lgpf/xpc-minimodem/stl/xpc-minimodem-cable-tpu.stl

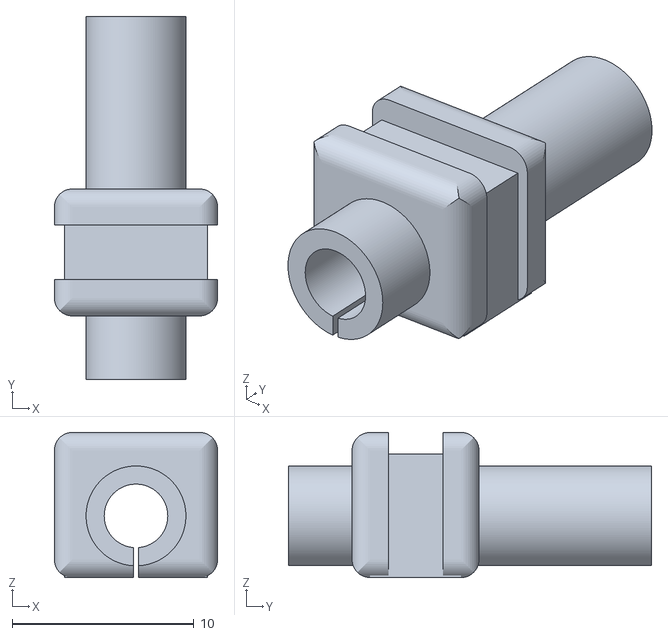
[picture p3: CAD file, 2026-11-09]
stl/xpc-minimodem-cable-tpu.stl
9.00 x 20.0 x 8.00
