lgpf/xpc-minimodem/stl/xpc-minimodem-top.stl

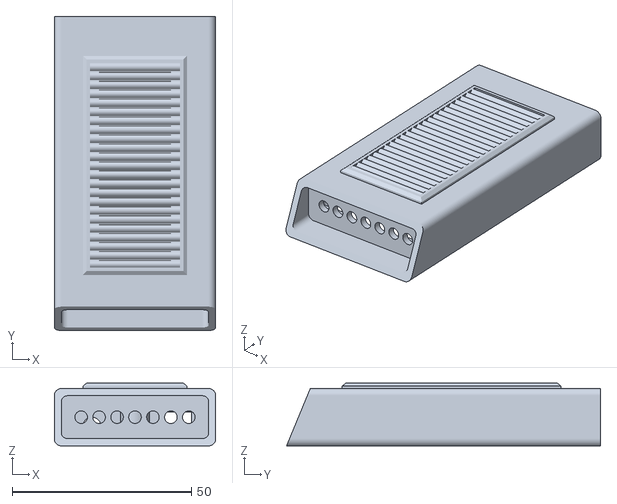
[picture p4: CAD file, 2026-11-09]
stl/xpc-minimodem-top.stl
45.0 x 87.5 x 17.5
