lgpf/xpc-minimodem/stl/xpc-minimodem-bottom.stl

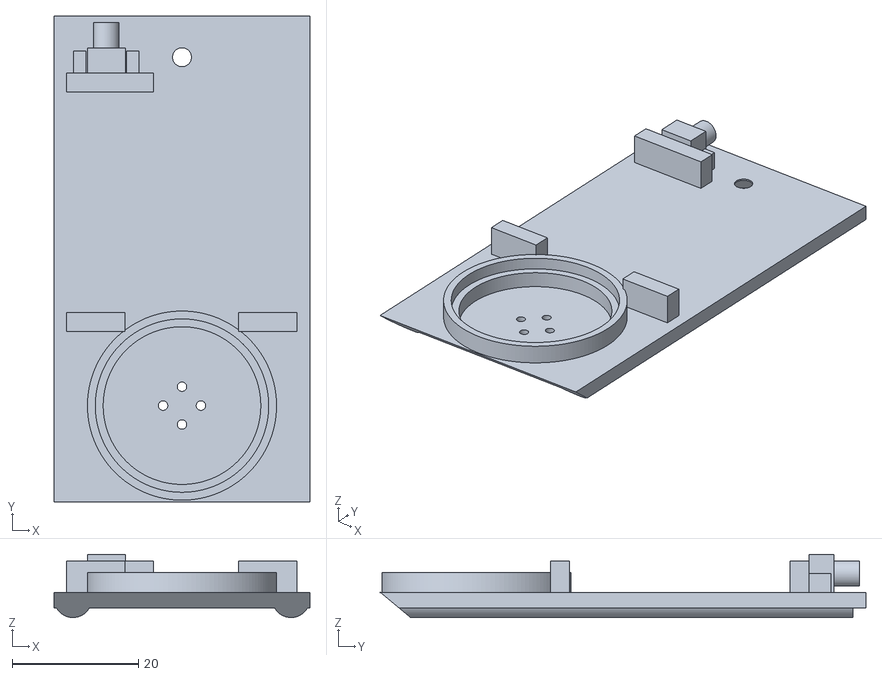
[picture p5: CAD file, 2026-11-09]
stl/xpc-minimodem-bottom.stl
40.6 x 77.0 x 10.0
