lgpf/xpc-minimodem/firmware/RetroWiFiModemXPC/RetroWiFiModem.h

#ifndef _MODEM_H
   #define _MODEM_H

   #define DEBUG                 0

   // XPC: versao para ligar direto na porta do mouse da TTGO VGA32 (Cobra XPC / FabGL PCEmulator):
   //   so TX/RX em TTL 3,3V, sem MAX3232, sem DFPlayer/som, sem sinais de controle (DTR/DCD/RTS/CTS/RI)
   #define XPC_DIRECT            1

   #if XPC_DIRECT
      #define DEFAULT_SPEED      9600
   #else
      #define DEFAULT_SPEED      1200
   #endif

   #define RING_INTERVAL         1500
   #define MAX_CMD_LEN           256
   #define TX_BUF_SIZE           256
   #define ESC_CHAR              '+'
   #define ESC_COUNT             3
   #define GUARD_TIME            1000
   #define MAGIC_NUMBER          0x5106
   #define MAX_SSID_LEN          32
   #define MAX_WIFI_PWD_LEN      64
   #define DEFAULT_LISTEN_PORT   6400
   #define TELNET_PORT           23
   #define HTTP_PORT             80
   #define SPEED_DIAL_SLOTS      10
   #define MAGIC_ANSWER_RINGS    3
   #define MAX_ALIAS_LEN         16
   #define MAX_SPEED_DIAL_LEN    50
   #define MAGIC_SPEED_LEN       7
   #define MAX_PPP_LEN           16
   #define MAX_MDNSNAME_LEN      80
   #define MAX_HOSTNAME_LEN      24
   #define MAX_BUSYMSG_LEN       80
   #define MAX_PWD_LEN           80
   #define PASSWORD_TIME         60000
   #define PASSWORD_TRIES        3
   #define MAX_AUTOEXEC_LEN      80
   #define MAX_TERMINAL_LEN      80
   #define MAX_LOCATION_LEN      80

   #define NUL  '\x00'
   #define CTLC '\x03'
   #define BS   '\x08'
   #define LF   '\x0A'
   #define CR   '\x0D'
   #define DEL  '\x7F'

   #define NO_TELNET   ((uint8_t)0)
   #define REAL_TELNET ((uint8_t)1)
   #define FAKE_TELNET ((uint8_t)2)

   // Telnet codes
   #define VLSUP     ((uint8_t)0)
   #define VLREQ     ((uint8_t)1)
   #define LOC       ((uint8_t)23)
   #define TTYPE     ((uint8_t)24)
   #define NAWS      ((uint8_t)31)
   #define TSPEED    ((uint8_t)32)
   #define LFLOW     ((uint8_t)33)
   #define LINEMODE  ((uint8_t)34)
   #define XDISPLOC  ((uint8_t)35)
   #define NEW_ENVIRON ((uint8_t)39)
   #define MSDP      ((uint8_t)69)  //
   #define MSSP      ((uint8_t)70)  //
   #define MCCP      ((uint8_t)85)  //
   #define MCCP2     ((uint8_t)86)  //
   #define MCCP3     ((uint8_t)87)  // MUD Telnet extensions
   #define MSP       ((uint8_t)91)  //
   #define MXP       ((uint8_t)93)  //
   #define GMCP      ((uint8_t)201) //
   #define BINARY    ((uint8_t)0)
   #define ECHO      ((uint8_t)1)
   #define SUP_GA    ((uint8_t)3)
   #define SE        ((uint8_t)240)
   #define DM        ((uint8_t)242)
   #define AYT       ((uint8_t)246)
   #define SB        ((uint8_t)250)
   #define WILL      ((uint8_t)251)
   #define WONT      ((uint8_t)252)
   #define DO        ((uint8_t)253)
   #define DONT      ((uint8_t)254)
   #define IAC       ((uint8_t)255)

   #define NIST_HOST "time.nist.gov"
   #define NIST_PORT 13

   #define ACTIVE LOW           // RS232 control signals are active low

   // As the ESP8266 is being used as a modem (DCE) in this application,
    // I've reversed the naming of RTS/CTS to match what they'd be on
    // a modem. The usual naming is correct if the ESP8266 is wired up as
    // a DTE, but kept confusing me here as it's wired up as a DCE.
   #ifdef ARDUINO_ESP8266_WEMOS_D1R1
      // D1 R1 pins
      #define CTS D10           // (GPIO15) output
      #define RTS D11           // (GPIO13) input
      #define RI  D12           // (GPIO12) output
      #define DSR D4            // (GPIO04) output
      #define DCD D3            // (GPIO05) output
      #define DTR D8            // (GPIO00) input
      #define TXEN D5           // (GPIO14) output
      #define BUSY D2           // (GPIO16) input
   #endif

   #ifdef ARDUINO_ESP8266_WEMOS_D1MINI
      // D1 mini pins
      #define CTS D8            // (GPIO15) output
      #define RTS D7            // (GPIO13) input
      #define RI  D6            // (GPIO12) output
      #define DSR D2            // (GPIO04) output
      #define DCD D1            // (GPIO05) output
      #define DTR D3            // (GPIO00) input
      #define TXEN D5           // (GPIO14) output
      #define BUSY D0           // (GPIO16) input
   #endif

   // Sound player definitions
   #define SOUND_DIAL_TONE 1
   #define SOUND_DIALLING (SOUND_DIAL_TONE+1)
   #define NUM_DIAL_SOUNDS 10
   #define SOUND_RING (SOUND_DIALLING+NUM_DIAL_SOUNDS)
   #define SOUND_CONNECT_300 (SOUND_RING+1)
   #define SOUND_CONNECT_1200 (SOUND_CONNECT_300+1)
   #define SOUND_CONNECT_9600 (SOUND_CONNECT_1200+1)

#endif
