lgpf/xpc-minimodem/firmware/RetroWiFiModemXPC/RetroWiFiModemXPC.ino

//
//   Retro WiFi modem: an ESP8266 based RS232<->WiFi modem
//   with Hayes style AT commands and blinking LEDs.
//
//   Originally based on
//   Original Source Copyright (C) 2016 Jussi Salin <salinjus@gmail.com>
//   Additions (C) 2018 Daniel Jameson, Stardot Contributors
//   Additions (C) 2018 Paul Rickards <rickards@gmail.com>
//
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

#include <lwip/napt.h>
#include <lwip/dns.h>
#include <lwip/netif.h>
#include <netif/ppp/ppp.h>
#include <netif/ppp/pppos.h>

#include <ESP8266WiFi.h>
#include <ESP_EEPROM.h>
#include <WiFiUdp.h>
#include <ArduinoOTA.h>
#include <uart_register.h>
#include <string.h>
#include "RetroWiFiModem.h"
#include "globals.h"
#include "support.h"
#include "player.h"
#if XPC_DIRECT
#include "xpcsound.h"
#endif
#include "ppp.h"
#include "at_basic.h"
#include "at_extended.h"
#include "at_proprietary.h"

// =============================================================
void setup(void) {
   bool ok = true;

   pinMode(RI, OUTPUT);
   pinMode(DCD, OUTPUT);
   pinMode(DSR, OUTPUT);
   digitalWrite(TXEN, HIGH);     // continue disabling TX until
   pinMode(TXEN, OUTPUT);        // we have set up the Serial port
   pinMode(DTR, INPUT);

   digitalWrite(RI, !ACTIVE);    // not ringing
   digitalWrite(DCD, !ACTIVE);   // not connected
   digitalWrite(DSR, !ACTIVE);   // modem is not ready

   // the esp fork of LWIP doesn't automatically init when enabling nat, so just do it in setup
   ip_napt_init(IP_NAPT_MAX, IP_PORTMAP_MAX);

   EEPROM.begin(sizeof(struct Settings));
   EEPROM.get(0, settings);
   if( settings.magicNumber != MAGIC_NUMBER ) {
      // no valid data in EEPROM/NVRAM, populate with defaults
      factoryDefaults(NULL);
   }
   sessionTelnetTypeSend = settings.telnet;
   sessionTelnetTypeReceive = settings.telnet;

   playerInit();
#if XPC_DIRECT
   sndInit();                    // piezo em D5 (GPIO14) e G
#endif
   playerSetVolume(settings.volume);
   if( !settings.speaker ) {
      playerMute();
   }

   Serial.begin(settings.serialSpeed, getSerialConfig());
   digitalWrite(TXEN, LOW);      // enable the TX output
   updateHardwareFlow();         // update CTS/RTS
#if XPC_DIRECT
   settings.rtsCts = false;                       // sem RTS/CTS no cabo
   settings.dtrHandling = DTR_IGNORE;             // sem DTR no cabo
#endif
   if( settings.rtsCts ) {
      setHardwareFlow();
   }
   // enable interrupt when DTR goes inactive if we're not ignoring it
   if( settings.dtrHandling != DTR_IGNORE ) {
      attachInterrupt(digitalPinToInterrupt(DTR), dtrIrq, RISING);
   }
   if( settings.startupWait ) {
      while( true ) {            // wait for a CR
         yield();
         if( Serial.available() ) {
            if( Serial.read() == CR ) {
               break;
            }
         }
      }
   }

   if( settings.hostName[0] ) {
     WiFi.hostname(settings.hostName);
   }

   WiFi.setAutoConnect(false);
   if( settings.ssid[0] && settings.wifiPassword[0] ) {
      WiFi.begin(settings.ssid, settings.wifiPassword);
      WiFi.waitForConnectResult();
      WiFi.mode(WIFI_STA);
   } else {
      WiFi.begin();
   }
   WiFiClient::setDefaultNoDelay(true);  // disable Nalge algorithm by default

   if( settings.listenPort ) {
      tcpServer.begin(settings.listenPort);
   }

   if( settings.ssid[0] && WiFi.status() == WL_CONNECTED ) {
      setupOTAupdates();
   }

   if( WiFi.status() == WL_CONNECTED || !settings.ssid[0] ) {
      if( WiFi.status() == WL_CONNECTED ) {
         digitalWrite(DSR, ACTIVE);  // modem is finally ready or SSID not configured
      }
      if( settings.autoExecute[0] ) {
         strncpy(atCmd, settings.autoExecute, MAX_CMD_LEN);
         atCmd[MAX_CMD_LEN] = NUL;
         if( settings.echo ) {
            Serial.println(atCmd);
         }
         doAtCmds(atCmd);                  // auto execute command
      } else {
         sendResult(R_OK);
      }
   } else {
      sendResult(R_ERROR);           // SSID configured, but not connected
   }

   playerSetVolume(settings.volume);
   if( !settings.speaker ) {
      playerMute();
   }
}

// =============================================================
void loop(void) {

   checkForIncomingCall();

   if( settings.dtrHandling == DTR_RESET && checkDtrIrq() ) {
      resetToNvram(NULL);
   }

   digitalWrite(DSR, WiFi.status() == WL_CONNECTED ? ACTIVE : !ACTIVE);

   switch( state ) {

      case CMD_NOT_IN_CALL:
         if( WiFi.status() == WL_CONNECTED ) {
            ArduinoOTA.handle();
         }
         inAtCommandMode();
         break;

      case CMD_IN_CALL:
         inAtCommandMode();
         if( state == CMD_IN_CALL && !ppp && !tcpClient.connected() ) {
            endCall();                    // hang up if not in a call
         }
         break;

      case PASSWORD:
         inPasswordMode();
         break;

      case ONLINE:
         if( Serial.available() ) {       // data from RS-232 to Wifi
            sendSerialData();
         }

         while( !ppp && tcpClient.available() && !Serial.available() ) { // data from WiFi to RS-232
            int c = receiveTcpData();
            if( c != -1 ) {
               Serial.write((char)c);
            }
         }

         if( escCount == ESC_COUNT && startGuardTime && millis() - startGuardTime > GUARD_TIME ) {
            state = CMD_IN_CALL;          // +++ detected, back to command mode
            sendResult(R_OK);
            escCount = 0;
         }

         if( settings.dtrHandling != DTR_IGNORE && checkDtrIrq() ) {
            switch( settings.dtrHandling ) {

               case DTR_GOTO_COMMAND:
                  state = CMD_IN_CALL;
                  sendResult(R_OK);
                  escCount = 0;
                  break;

               case DTR_END_CALL:
                  endCall();
                  break;

               case DTR_RESET:
                  resetToNvram(NULL);
                  break;

               default:
                  break;
            }
         }

         if( !ppp && !tcpClient.connected() ) {   // no client?
            endCall();                    // then hang up
         }
         break;
   }
}

// =============================================================
void doAtCmds(char *atCmd) {
   size_t len;

   trim(atCmd);               // get rid of leading and trailing spaces
   if( atCmd[0] ) {
      // is it an AT command?
      if( strncasecmp(atCmd, "AT", 2) ) {
         sendResult(R_ERROR); // nope, time to die
      } else {
         // save command for possible future A/
         strncpy(lastCmd, atCmd, MAX_CMD_LEN);
         lastCmd[MAX_CMD_LEN] = NUL;
         atCmd += 2;          // skip over AT prefix
         len = strlen(atCmd);

         if( !atCmd[0] ) {
            // plain old AT
            sendResult(R_OK);
         } else {
            trim(atCmd);
            while( atCmd[0] ) {
               char * before = atCmd;   // XPC: comando que nao avanca (erro) encerra a linha
               // XPC: "AT?" sozinho e sempre a ajuda (mesmo depois de um ATSn da string de init do terminal)
               if( !strncasecmp(atCmd, "?", 1) && (selectedRegister < 0 || !atCmd[1]) ) { // help message
                  // help
                  atCmd = showHelp(atCmd + 1);
               } else if( !strncasecmp(atCmd, "$AYT", 4) ) {
                  atCmd = doAreYouThere(atCmd + 4);
               } else if( !strncasecmp(atCmd, "$SB", 3) ) {
                  // query/set serial speed
                  atCmd = doSpeedChange(atCmd + 3);
               } else if( !strncasecmp(atCmd, "$SU", 3) ) {
                  // query/set serial data configuration
                  atCmd = doDataConfig(atCmd + 3);
               } else if( !strncasecmp(atCmd, "$SSID", 5) ) {
                  // query/set WiFi SSID
                  atCmd = doSSID(atCmd + 5);
               } else if( !strncasecmp(atCmd, "$PASS", 5) ) {
                  // query/set WiFi password
                  atCmd = doWiFiPassword(atCmd + 5);
               } else if( !strncasecmp(atCmd, "C", 1) ) {
                  // connect/disconnect to WiFi
                  atCmd = wifiConnection(atCmd + 1);
               } else if( !strncasecmp(atCmd, "D", 1) && len > 2 && strchr("TPI", toupper(atCmd[1])) ) {
                  // dial a number
                  atCmd = dialNumber(atCmd + 2);
               } else if( !strncasecmp(atCmd, "DS", 2) && len == 3 ) {
                  // speed dial a number
                  atCmd = speedDialNumber(atCmd + 2);
               } else if( !strncasecmp(atCmd, "H0", 2) ) {
                  // hang up call
                  atCmd = hangup(atCmd + 2);
               } else if( !strncasecmp(atCmd, "H", 1) && !isDigit(atCmd[1]) ) {
                  // hang up call
                  atCmd = hangup(atCmd + 1);
               } else if( !strncasecmp(atCmd, "&Z", 2) && isDigit(atCmd[2]) ) {
                  // speed dial query or set
                  atCmd = doSpeedDialSlot(atCmd + 2);
               } else if( !strncasecmp(atCmd, "L", 1) ) {
                  // query/set speaker volume
                  atCmd = doSpeakerVolume(atCmd + 1);
               } else if( !strncasecmp(atCmd, "M", 1) ) {
                  // turn speaker on/off
                  atCmd = doSpeaker(atCmd + 1);
               } else if( !strncasecmp(atCmd, "O", 1) ) {
                  // go online
                  atCmd = goOnline(atCmd + 1);
               } else if( !strncasecmp(atCmd, "GET", 3) ) {
                  // get a web page (http only, no https)
                  atCmd = httpGet(atCmd + 3);
               } else if( settings.listenPort && !strncasecmp(atCmd, "A", 1) && tcpServer.hasClient() ) {
                  // manually answer incoming connection
                  atCmd = answerCall(atCmd + 1);
               } else if( !strncasecmp(atCmd, "S", 1) && isDigit(atCmd[1]) ) {
                  // select register
                  atCmd = doSelectRegister(atCmd + 1);
               } else if ( !strncasecmp(atCmd, "=", 1) && isDigit(atCmd[1]) ) {
                  // set register
                  atCmd = doSetRegister(atCmd + 1);
               } else if ( !strncasecmp(atCmd, "?", 1) ) {
                  // query register
                  atCmd = doQueryRegister(atCmd + 1);
               } else if( !strncasecmp(atCmd, "S0", 2) ) {
                  // query/set auto answer
                  atCmd = doAutoAnswerConfig(atCmd + 2);
               } else if( !strncasecmp(atCmd, "S2", 2) ) {
                  // query/set escape character
                  atCmd = doEscapeCharConfig(atCmd + 2);
               } else if( !strncasecmp(atCmd, "$SP", 3) ) {
                  // query set inbound TCP port
                  atCmd = doServerPort(atCmd + 3);
               } else if( !strncasecmp(atCmd, "$BM", 3) ) {
                  // query/set busy message
                  atCmd = doBusyMessage(atCmd + 3);
               } else if( !strncasecmp(atCmd, "&R", 2) && strncasecmp(atCmd + 2, "S", 1) ) {
                  // query/set require password
                  atCmd = doServerPassword(atCmd + 2);
               } else if( !strncasecmp(atCmd, "I", 1) ) {
                  // show network information
                  atCmd = showNetworkInfo(atCmd + 1);
               } else if( !strncasecmp(atCmd, "Z", 1) ) {
                  // reset to NVRAM
                  atCmd = resetToNvram(atCmd + 1);
               } else if( !strncasecmp(atCmd, "&D", 2) ) {
                  //query/set DTR handling
                  atCmd = doDtrHandling(atCmd + 2);
               } else if( !strncasecmp(atCmd, "&V", 2) ) {
                  // display current and stored settings
                  atCmd = displayAllSettings(atCmd + 2);
               } else if( !strncasecmp(atCmd, "&W", 2) ) {
                  // write settings to EEPROM
                  atCmd = updateNvram(atCmd + 2);
               } else if( !strncasecmp(atCmd, "&F", 2) ) {
                  // factory defaults
                  atCmd = factoryDefaults(atCmd);
               } else if( !strncasecmp(atCmd, "E", 1) ) {
                  // query/set command mode echo
                  atCmd = doEcho(atCmd + 1);
               } else if( !strncasecmp(atCmd, "Q", 1) ) {
                  // query/set quiet mode
                  atCmd = doQuiet(atCmd + 1);
               } else if( !strncasecmp(atCmd, "RD", 2)
                       || !strncasecmp(atCmd, "RT", 2) ) {
                  // read time and date
                  atCmd = doDateTime(atCmd + 2);
               } else if( !strncasecmp(atCmd, "V", 1) ) {
                  // query/set verbose mode
                  atCmd = doVerbose(atCmd + 1);
               } else if( !strncasecmp(atCmd, "X", 1) ) {
                  // query/set extended result codes
                  atCmd = doExtended(atCmd + 1);
               } else if( !strncasecmp(atCmd, "$W", 2) ) {
                  // query/set startup wait
                  atCmd = doStartupWait(atCmd + 2);
               } else if( !strncasecmp(atCmd, "NET", 3) ) {
                  // query/set telnet mode
                  atCmd = doTelnetMode(atCmd + 3);
               } else if( !strncasecmp(atCmd, "$AE", 3) ) {
                  // do auto execute commands
                  atCmd = doAutoExecute(atCmd + 3);
               } else if( !strncasecmp(atCmd, "$TTY", 4) ) {
                  // do telnet terminal type
                  atCmd = doTerminalType(atCmd + 4);
               } else if( !strncasecmp(atCmd, "$TTL", 4) ) {
                  // do telnet location
                  atCmd = doLocation(atCmd + 4);
               } else if( !strncasecmp(atCmd, "$TTS", 4) ) {
                  // do telnet location
                  atCmd = doWindowSize(atCmd + 4);
               } else if( !strncasecmp(atCmd, "&K", 2) ) {
                  // do RTS/CTS flow control
                  atCmd = doFlowControl(atCmd + 2);
               } else if( !strncasecmp(atCmd, "&CS", 3) ) {
                  // do manual CTS control
                  atCmd = doCtsControl(atCmd + 3);
               } else if( !strncasecmp(atCmd, "&RS", 3) ) {
                  // do manual RTS control
                  atCmd = doRtsControl(atCmd + 3);
               } else if( !strncasecmp(atCmd, "$MDNS", 5) ) {
                  // handle mDNS name
                  atCmd = doMdnsName(atCmd + 5);
               } else if( !strncasecmp(atCmd, "$HOST", 5) ) {
                  // handle hostname
                  atCmd = doHostName(atCmd + 5);
               } else if( !strncasecmp(atCmd, "M", 1) ) {
                  // speaker mute
                  atCmd = doSpeakerMute(atCmd + 1);
               } else if( !strncasecmp(atCmd, "L", 1) ) {
                  // speaker loudness
                  atCmd = doSpeakerLoudness(atCmd + 1);
               } else if( !strncasecmp(atCmd, "+FCLASS=", 8) ) {
                  // voice mode
                  atCmd = doVoiceMode(atCmd + 8);
               } else if( !strncasecmp(atCmd, "#CLS=", 5) ) {
                  // voice mode
                  atCmd = doVoiceMode(atCmd + 5);
               } else if ( !strncasecmp(atCmd, "$PPP", 4) ) {
                  // PPP number
                  atCmd = doPPP(atCmd + 4);
               } else {
                  // unrecognized command
                  sendResult(R_ERROR);
                  break;      // XPC: para aqui (o resto da linha nao e interpretado)
               }
               if( atCmd == before ) {
                  break;      // XPC: o comando deu erro sem consumir nada (evita repetir ERROR sem fim)
               }
               trim(atCmd);
            }
         }
      }
   }
}
