lgpf/xpc-minimodem/firmware/RetroWiFiModemXPC/handshake.h

// handshake de modem (gravacao 0015 do RetroWiFiModem original), 8 kHz, 8 bits sem sinal
#pragma once
#define HANDSHAKE_LEN 70308
const uint8_t handshakePCM[HANDSHAKE_LEN] PROGMEM = {
  125,124,125,125,125,125,125,125,126,127,128,127,127,127,127,127,127,127,127,127,127,127,127,127,
  127,127,127,127,127,127,127,127,127,127,127,127,127,127,127,127,127,127,127,127,127,127,127,127,
  127,127,127,127,127,127,127,127,127,127,127,127,127,127,127,127,127,127,127,127,127,127,127,127,
  127,127,127,127,127,127,127,127,127,127,127,127,127,127,127,127,127,127,127,127,127,127,127,127,
  127,127,127,127,127,127,127,127,127,127,126,127,127,127,127,127,127,128,127,127,127,127,127,127,
  127,127,127,127,127,127,127,127,127,127,127,127,127,127,127,127,127,127,127,127,127,127,127,127,
  127,126,125,125,125,127,128,127,127,127,127,127,127,127,127,127,127,127,127,127,127,127,127,127,
  127,127,127,127,127,127,127,127,127,127,127,127,127,127,127,127,127,127,127,126,127,127,127,126,
  127,127,127,127,127,127,127,127,127,127,127,127,127,127,127,127,127,127,127,127,127,127,127,127,
  127,127,127,127,127,127,127,127,127,127,127,127,127,127,127,127,127,127,127,127,127,127,127,127,
  127,127,127,127,127,127,127,127,127,127,127,127,127,127,127,127,127,127,127,127,127,127,127,127,
  127,127,127,127,127,127,127,127,127,127,127,127,127,127,127,127,127,127,127,127,126,127,127,127,
  127,127,127,127,127,127,127,127,127,127,127,127,127,127,127,127,127,127,127,127,127,127,127,127,
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
  128,127,127,128,128,128,127,127,127,127,127,127,127,127,127,127,127,127,127,127,127,127,127,127,
  127,127,127,127,127,127,127,127,127,127,127,127,127,127,127,127,127,127,127,127,127,127,127,127,
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
};
