lgpf/xpc-minimodem/(commit log)

2026-11-09 XPC Mini Modem - first public release
    [xpc-minimodem-bottom.stl, xpc-minimodem-top.stl]
2026-11-09 README: case photo, English wiring diagram, TPU strain relief, flashing steps
    [xpc-minimodem-cable-tpu.stl]
2026-11-09 Wiring diagram: capacitors and optional piezo
